ThrudTheBarbarian/gd32/gd32.pdf

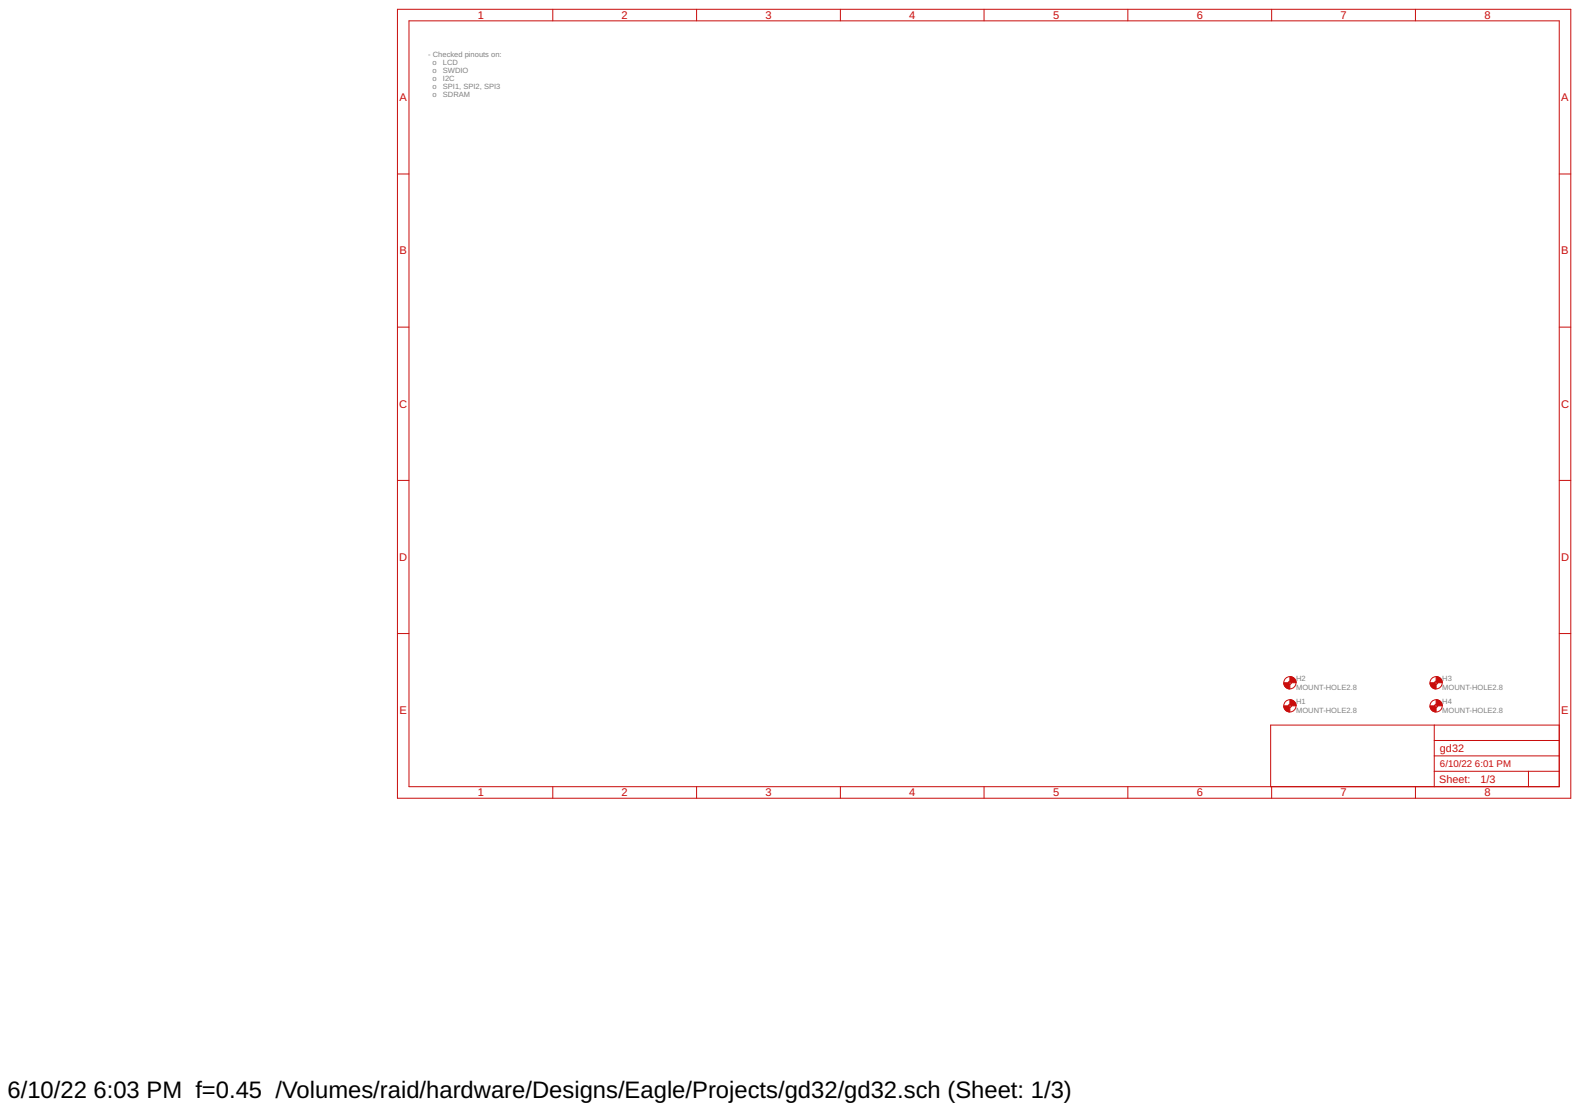
[picture p1: page 1]

- Checked pinouts on: o LCD

6/10/22 6:03 PM f=0.45 /Volumes/raid/hardware/Designs/Eagle/Projects/gd32/gd32.sch (Sheet: 1/3)

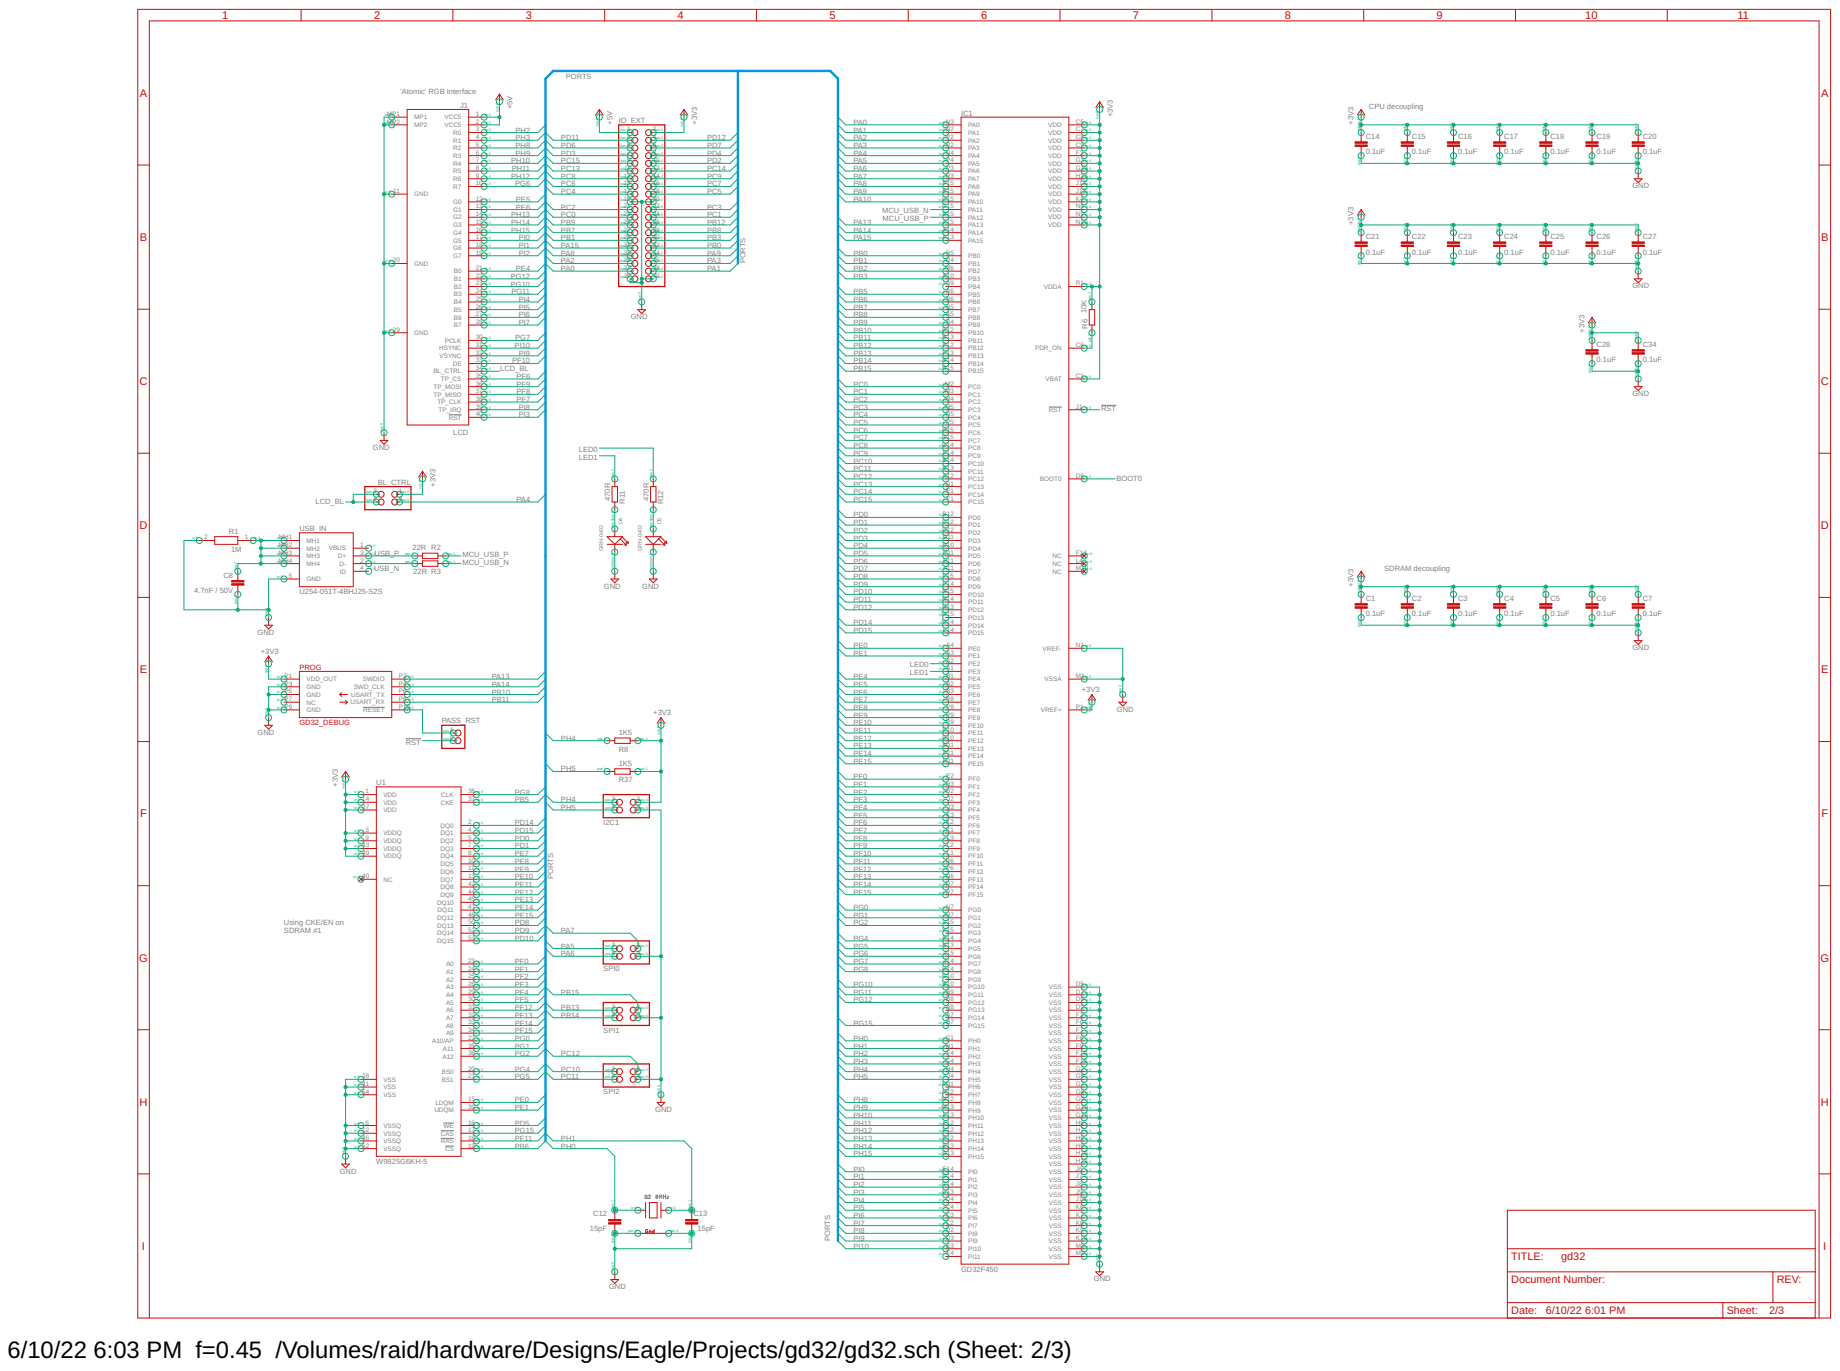
[picture p2: page 2]

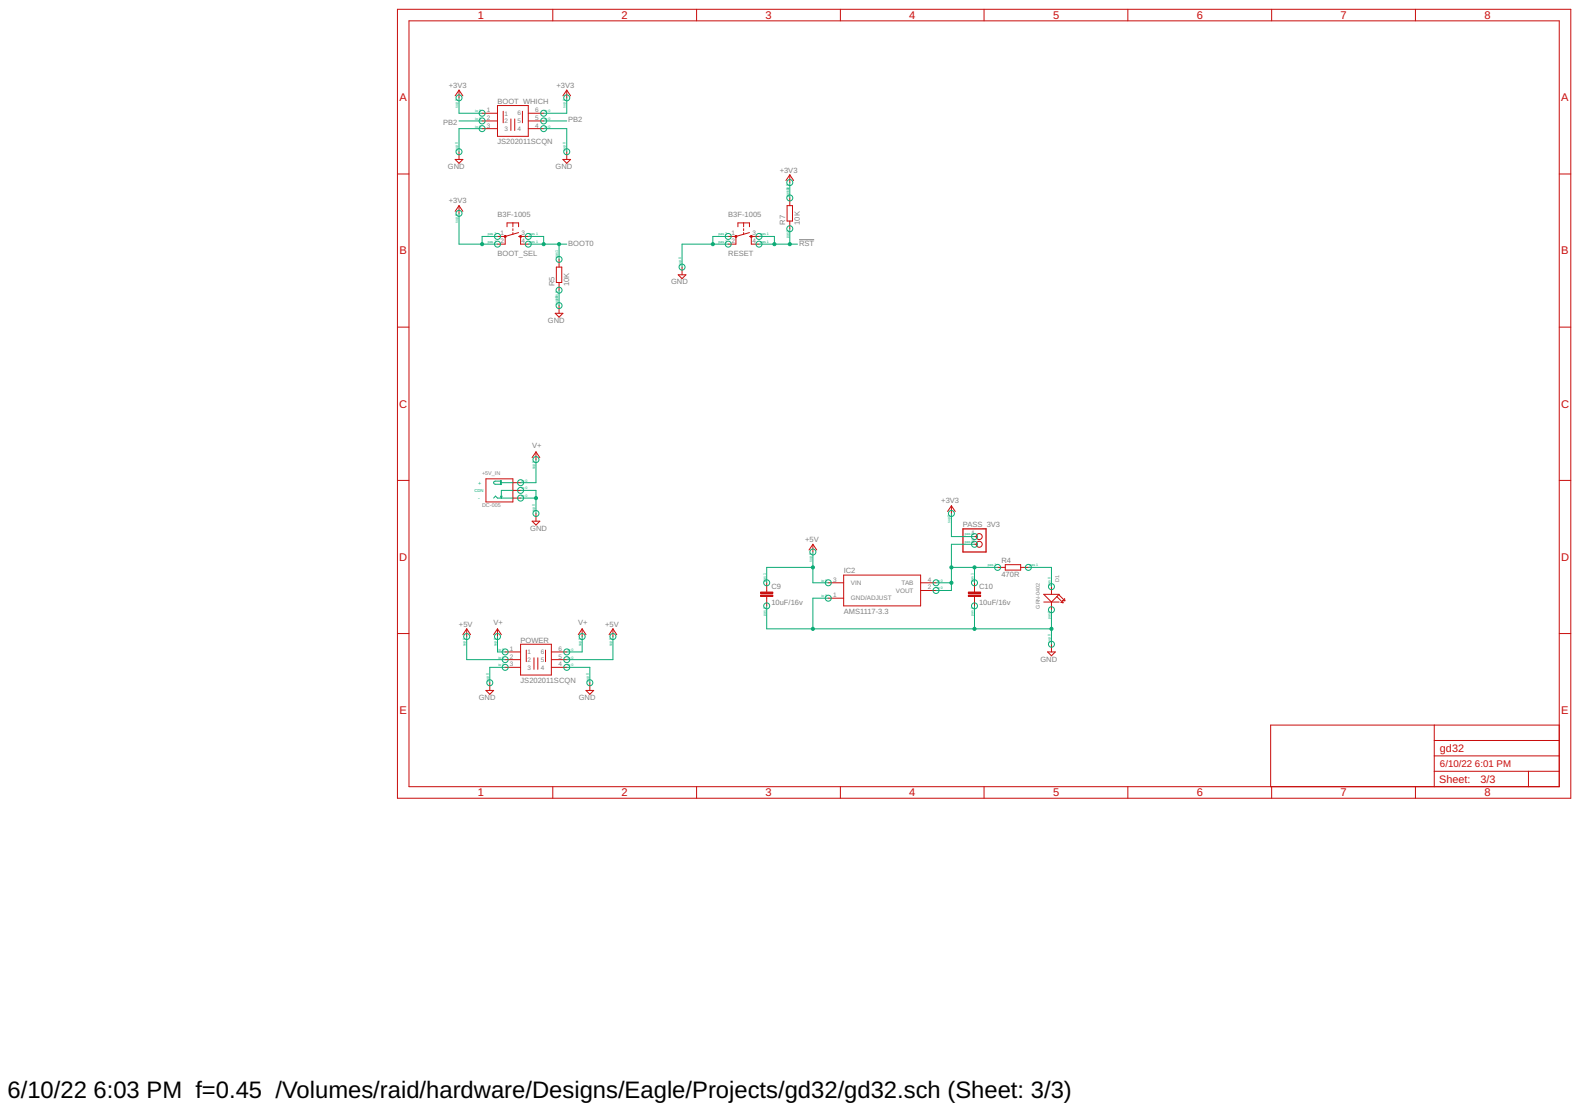
[picture p3: page 3]

6/10/22 6:03 PM f=0.45 /Volumes/raid/hardware/Designs/Eagle/Projects/gd32/gd32.sch (Sheet: 3/3)
