ThrudTheBarbarian/gd32/(commit log)

2022-06-08 Initial import
    [gd32.brd, gd32.sch]
2022-06-08 Incremental changes
    [gd32.brd, gd32.sch]
2022-06-09 Ready for manufacture
    [gd32.brd, gd32.sch]
2022-06-09 Add the bom and the pin-map
    [gd32_eagle_bom.csv]
2022-06-11 Sent off for manufacture, with corrected 1K5 pullups on I2C
    [gd32.brd, gd32.sch, gd32_centroid.csv, gd32_nextpcb_bom.csv]
2022-06-11 Persist the correct new pullup parts in the USE tags of the schematic components
    [gd32.brd, gd32.sch]
2022-06-17 Alter the pad sizes in the GD32 library
    [gd32.brd, gd32.sch]
