ThrudTheBarbarian/gd32/(notices)

Notices in the files:
gd32.brd:
© 2022 SjG
parts and their libraries:
SparkFun: Licensing: CC v3.0 Share-Alike You are welcome to use this library for commercial purposes.
